JosefR/hvac-sensor-module/readme.md

# Villa Control - HVAC Sensor Module

A simple sonsor module for measuring room temperature and humidity with a CAN
bus interface.

Power: 5-36 V DC

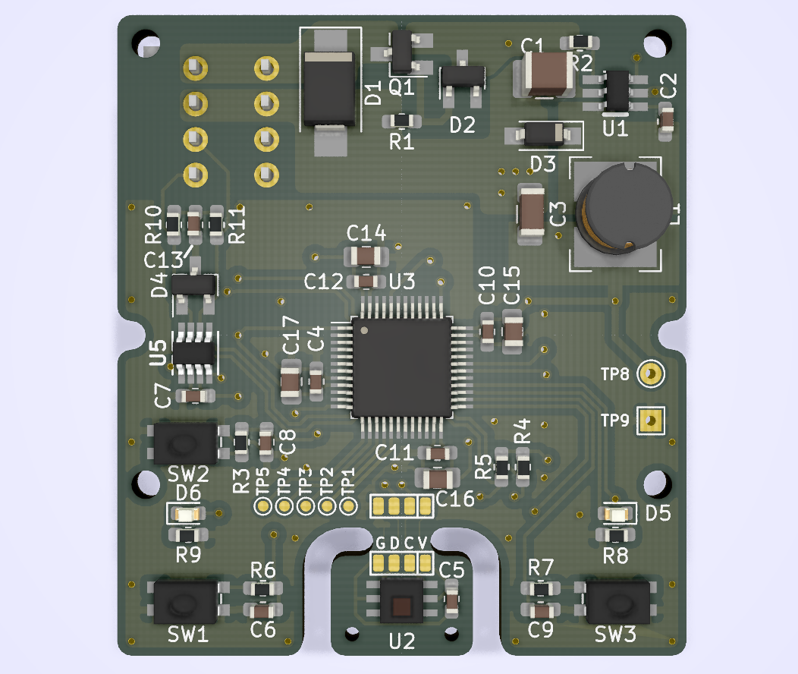
[picture p1: doc/render_front.png]
Image of Sensor Module
