JosefR/hvac-sensor-module/doc/render.png

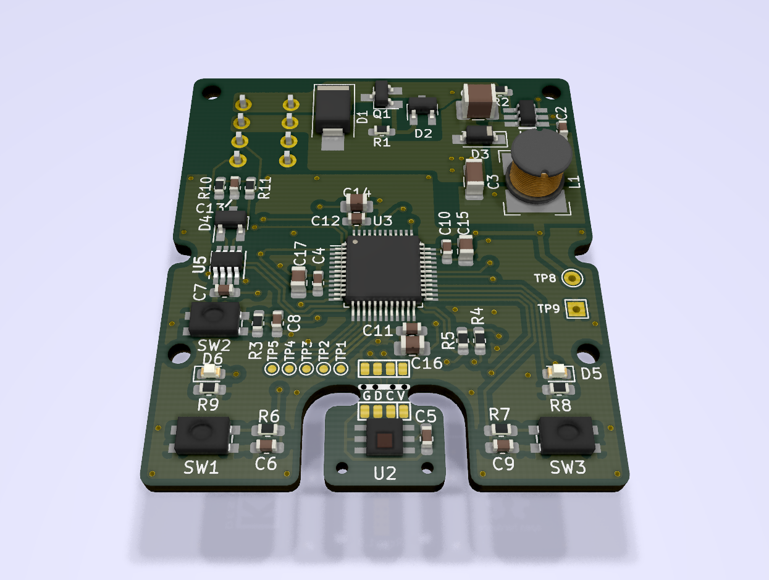
doc/render.png
