JosefR/hvac-sensor-module/doc/render_bottom.png

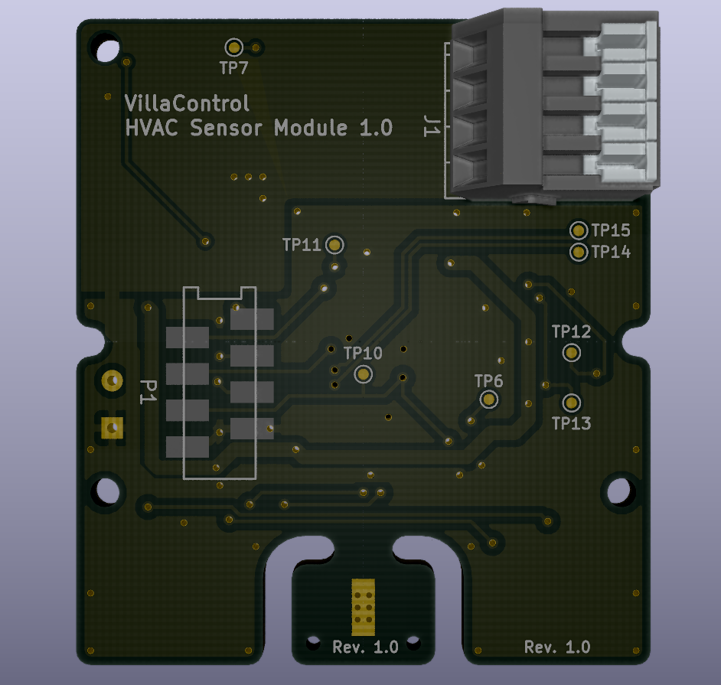
doc/render_bottom.png
