JosefR/hvac-sensor-module/hvac-sensor-module_bom.ods

Position | Value | Footprint | Quantity per PCB | Manufacturer | Distributor | Distributor Link | Distributor Part Number | Price per 1 piece | Price Total | Comment
1 | 100n | C_0603_1608Metric_Pad1.05x0.95mm_HandSolder | 10 | [generic] | Reichelt | https://www.reichelt.de/smd-vielschicht-keramikkondensator-100n-10-x7r-g0603-100n-p31873.html?trstct=pol_0 | X7R-G0603 100N | 0.02 | 0.2
2 | 2.2µF | C_1210_3225Metric_Pad1.42x2.65mm_HandSolder | 1 | [generic] | Reichelt | https://www.reichelt.de/vielschicht-kerko-2-2-f-50v-125-c-kem-x7r1210-2-2u-p207175.html? | KEM X7R1210 2,2U | 0.25 | 0.25 | avalability critical
3 | 22µF | C_1206_3216Metric_Pad1.42x1.75mm_HandSolder | 1 | [generic] | Reichelt | https://www.reichelt.de/smd-vielschichtkondensator-g1206-22-f-10v-x7r-g1206-22-10-p89742.html?trstct=pos_0 | X7R-G1206 22/10 | 0.26 | 0.26
4 | 4n7 | C_0603_1608Metric_Pad1.05x0.95mm_HandSolder | 1 | [generic] | Reichelt | https://www.reichelt.de/vielschicht-kerko-4-7nf-50v-125-c-kem-x7r0603-4-7n-p206991.html?trstct=pol_2 | KEM X7R0603 4,7N | 0.02 | 0.02
5 | 4µ7 | C_0805_2012Metric_Pad1.15x1.40mm_HandSolder | 4 | [generic] | Reichelt | https://www.reichelt.de/smd-kerko-0805-4-7-f-10v-10-mlcc-x5r-0805-cc-4-7u-p194215.html?&trstct=pol_3 | X5R 0805 CC 4,7U | 0.03 | 0.12
6 | 10V | D_SOT-23_ANK_Handsolder | 1 | ON Semiconductor | Mouser | https://www.mouser.de/ProductDetail/ON-Semiconductor/BZX84C10LT1G | 863-BZX84C10LT1G | 0.122 | 0.122
7 | 40.2V | D_SMB_Handsoldering | 1 | Littelfuse | Reichelt | https://www.reichelt.de/zenerdiode-40-v-600-w-do-214aa-p6smb-40ca-smd-p204319.html?&trstct=pos_0 | P6SMB 40CA SMD | 0.17 | 0.17
8 | 50V Vr 1A | D_SOD-123_Handsolder | 1 | ON Semiconductor | Mouser | https://www.mouser.de/ProductDetail/863-NRVTS260ESFT1G | 863-NRVTS260ESFT1G | 0.314 | 0.314
9 | NUP2105L | SOT-23_Handsoldering | 1 | ON Semiconductor | Mouser | https://www.mouser.de/ProductDetail/863-NUP2105LT1G | 863-NUP2105LT1G | 0.341 | 0.341
10 | red | LED_0603_1608Metric_Pad0.88x0.95mm_HandSolder | 2 | Osram | Reichelt | https://www.reichelt.de/led-smd-0603-rot-28-mcd-160-oso-lsq976-p231725.html?&trstct=pol_2 | OSO LSQ976 | 0.06 | 0.12
11 | Conn_01x04 | WAGO_218-104 | 1 | Wago | Voelkner | https://www.voelkner.de/products/55717/WAGO-Federkraftklemmblock-0.50mm-Polzahl-4-Grau-1St..html | D57985 | 1.16 | 1.16
12 | 27µH 220mΩ | SDR0604 | 1 | Bourns | Mouser | https://www.mouser.de/ProductDetail/652-SDR0604-270YL | 652-SDR0604-270YL | 0.41 | 0.41
13 | Debug | micromatch_smd_2x04 | 1 | [generic] | Reichelt | https://www.reichelt.de/buchsenleisten-micro-match-smd-1-27-mm-2x04-mpe-374-1-008-p120025.html? | MPE 374-1-008 | 0.39 | 0.39
14 | FDN5618P | SuperSOT-3_HandSoldering | 1 | Fairchild | Mouser | https://www.mouser.de/ProductDetail/512-FDN5618P | 512-FDN5618P | 0.42 | 0.42
15 | 100k | R_0603_1608Metric_Pad1.05x0.95mm_HandSolder | 2 | [generic] | Reichelt | https://www.reichelt.de/smd-widerstand-0603-100-kohm-100-mw-1-rnd-0603-1-100k-p183102.html? | RND 0603 1 100K | 0.02 | 0.04
16 | 220 | R_0603_1608Metric_Pad1.05x0.95mm_HandSolder | 3 | [generic] | Reichelt | https://www.reichelt.de/smd-widerstand-0603-220-ohm-100-mw-1-rnd-0603-1-220-p183020.html?trstct=pos_0 | RND 0603 1 220 | 0.02 | 0.06
17 | 3.3k | R_0603_1608Metric_Pad1.05x0.95mm_HandSolder | 4 | [generic] | Reichelt | https://www.reichelt.de/smd-widerstand-0603-3-3-kohm-100-mw-1-rnd-0603-1-3-3k-p183065.html?r=1 | RND 0603 1 3,3K | 0.02 | 0.08
18 | 60.4 1% | R_0603_1608Metric_Pad1.05x0.95mm_HandSolder | 2 | [generic] | Reichelt | https://www.reichelt.de/smd-widerstand-0603-60-4-ohm-100-mw-1-rnd-0603-1-60-4-p213146.html?r=1 | RND 0603 1 60,4 | 0.02 | 0.04
19 | SW_PUSH | KMR2_HandSolder | 3 | CK Switches | Reichelt | https://www.reichelt.de/smd-kurzhubtaster-4-2-x-2-8-mm-hoehe-1-9-mm-kmr-231-g-lfs-p148478.html?trstct=pos_0 | KMR 231 G LFS | 0.25 | 0.75
20 | HDC1080 | HDC1080_HandSoldering | 1 | Texas Instruments | Mouser | https://www.mouser.de/ProductDetail/595-HDC1080DMBR | 595-HDC1080DMBR | 2.45 | 2.45
21 | LMR16006 | TI-DDC_HandSoldering | 1 | Texas Instruments | Mouser | https://www.mouser.de/ProductDetail/595-MR16006YQ3DDCRQ1 | 595-MR16006YQ3DDCRQ1 | 2.88 | 2.88
22 | STM32F072C8Tx | LQFP-48_7x7mm_P0.5mm | 1 | ST Microelectronics | Mouser | https://www.mouser.de/ProductDetail/511-STM32F072C8T6 | 511-STM32F072C8T6 | 2.75 | 2.75
23 | TCAN334 | TI-DCN | 1 | Texas Instruments | Mouser | https://www.mouser.de/ProductDetail/595-TCAN334DCNR | 595-TCAN334DCNR | 2.2 | 2.2
