JosefR/hvac-sensor-module/hvac-sensor-module.pdf

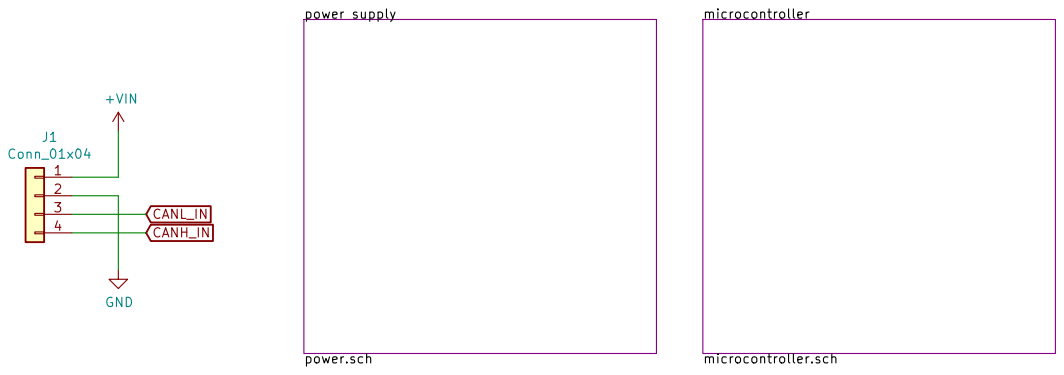
[picture p4: page 1]

File: hvac-sensor-module.sch Sheet: / Josef Raschen

Id: 1/3 Title: VillaControl - HVAC Sensor Module

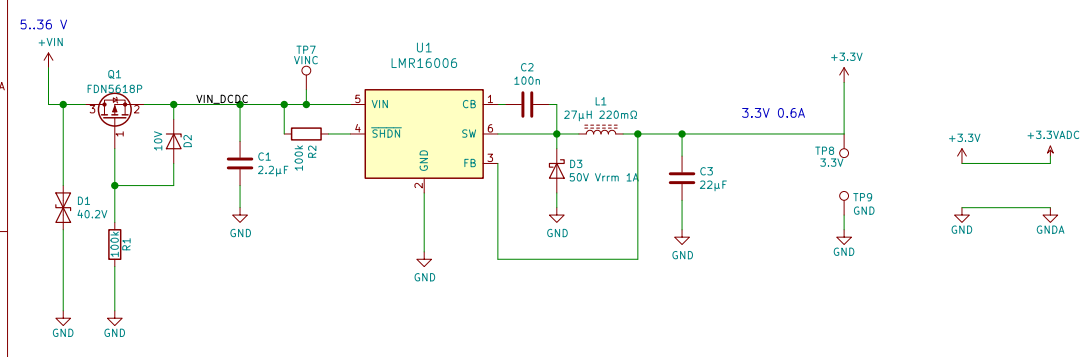
[picture p5: page 2]

2 FB 3 SHDN 4 VIN 5 SW 6 U1
LMR16006

Sheet: /power supply/ Josef Raschen

File: power.sch
Id: 2/3 Title: VillaControl - HVAC Sensor Module

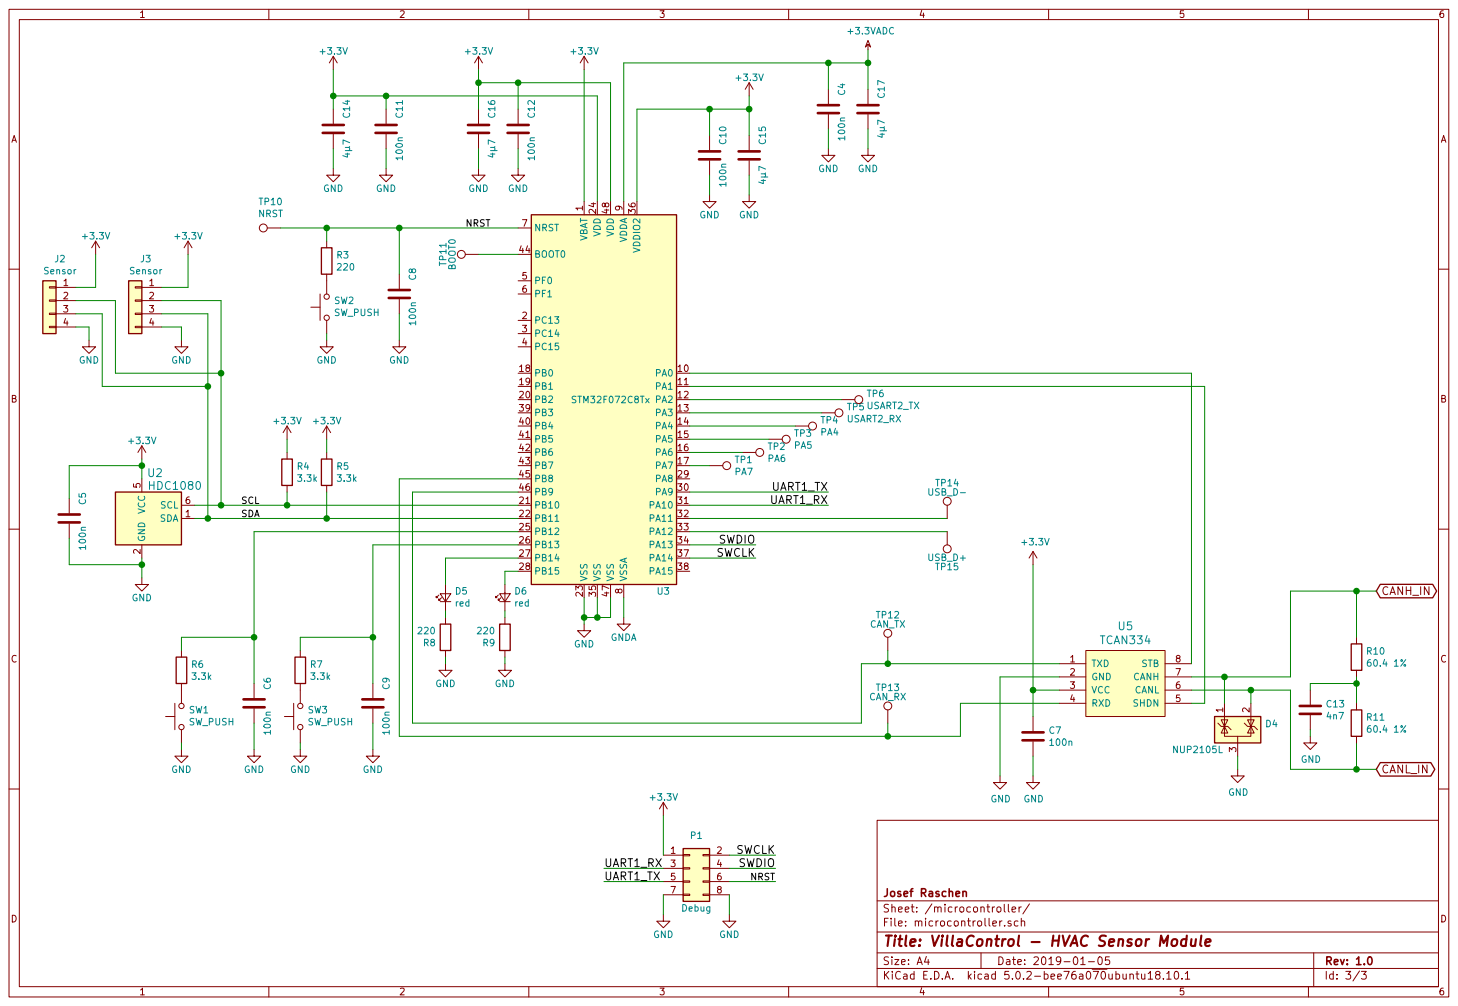
[picture p6: page 3]

9 VDDIO2 36 VSS 23 VSS 35 VSS 47 VSSA

File: microcontroller.sch Sheet: /microcontroller/ Josef Raschen

Id: 3/3 Title: VillaControl - HVAC Sensor Module
