JosefR/hvac-sensor-module/hvac-sensor-module.kicad_pcb

## KiCad design hvac-sensor-module.kicad_pcb (2019-01-09)

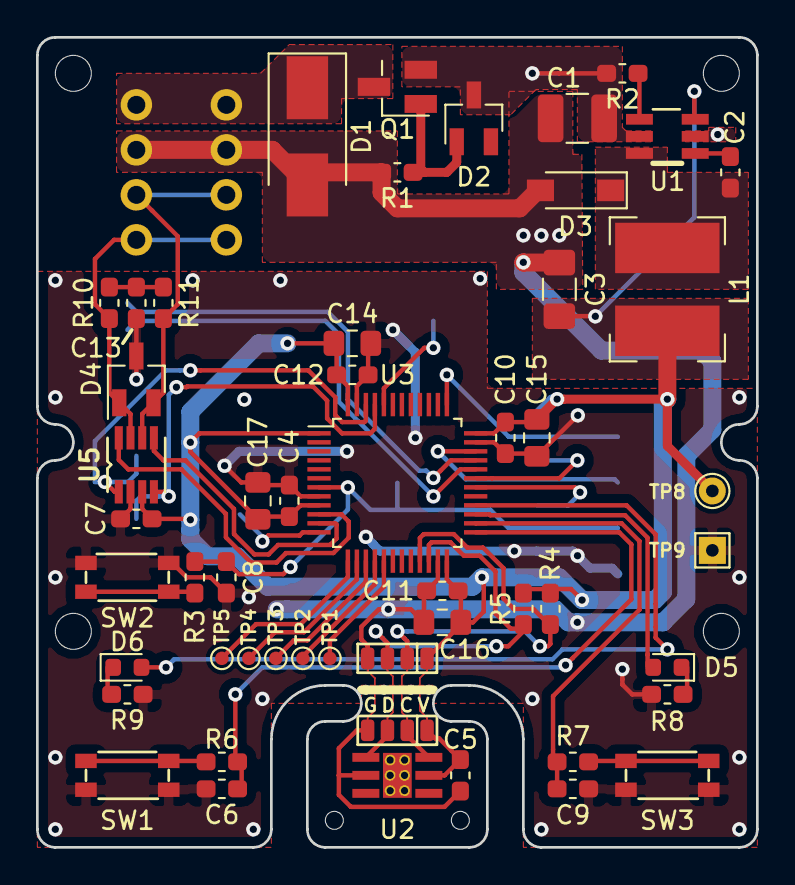
[picture p7: board hvac-sensor-module.kicad_pcb from above]

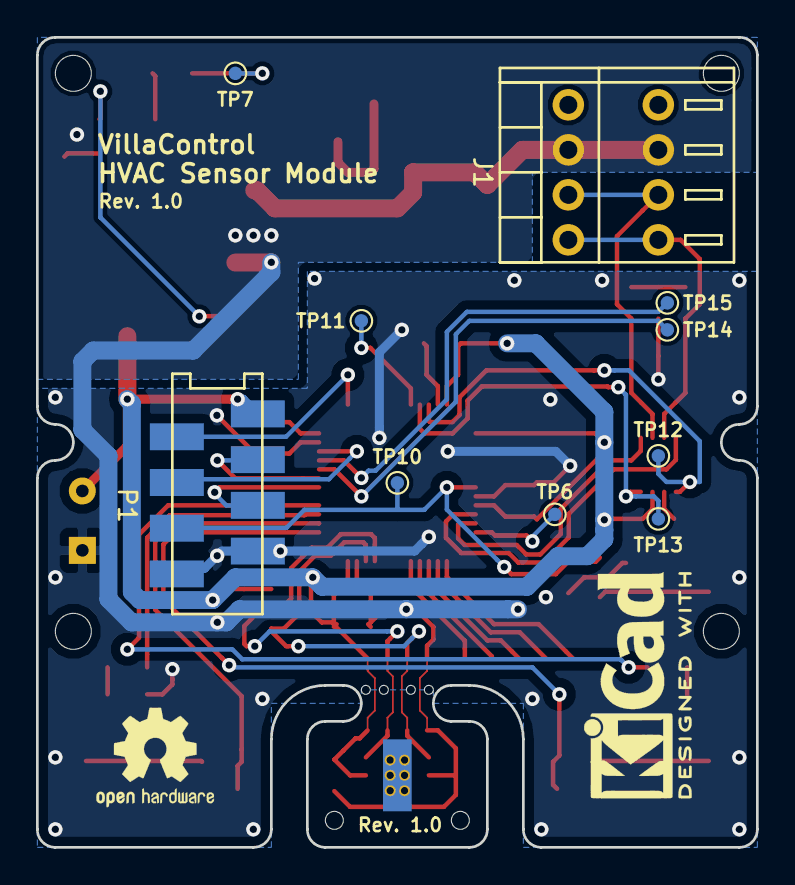
[picture p8: board hvac-sensor-module.kicad_pcb from below]

Board: 2 copper layers, 40.0 x 45.0 mm, 62 parts (10 on the bottom side), 40 nets.

Parts:
C1: 2.2µF; C_1210_3225Metric_Pad1.42x2.65mm_HandSolder
C2, C4, C5, C6, C7, C8, C9, C10, C11, C12: 100n; C_0603_1608Metric_Pad1.05x0.95mm_HandSolder
C3: 22µF; C_1206_3216Metric_Pad1.42x1.75mm_HandSolder
C13: 4n7; C_0603_1608Metric_Pad1.05x0.95mm_HandSolder
C14, C15, C16, C17: 4µ7; C_0805_2012Metric_Pad1.15x1.40mm_HandSolder
D1: 40.2V; D_SMB_Handsoldering
D2: 10V; D_SOT-23_ANK_Handsolder
D3: 50V Vrrm 1A; D_SOD-123_Handsolder
D4: NUP2105L; SOT-23_Handsoldering
D5, D6: red; LED_0603_1608Metric_Pad0.88x0.95mm_HandSolder
J1: Conn_01x04; WAGO_218-104
J2, J3: Sensor; Solder_Connecor_1x04
L1: 27µH 220mΩ; L_Bourns-SDR0604
P1: Debug; micromatch_smd_2x04
Q1: FDN5618P; SuperSOT-3_HandSoldering
R1, R2: 100k; R_0603_1608Metric_Pad1.05x0.95mm_HandSolder
R3, R8, R9: 220; R_0603_1608Metric_Pad1.05x0.95mm_HandSolder
R4, R5, R6, R7: 3.3k; R_0603_1608Metric_Pad1.05x0.95mm_HandSolder
R10, R11: 60.4 1%; R_0603_1608Metric_Pad1.05x0.95mm_HandSolder
SW1, SW2, SW3: SW_PUSH; KMR2_HandSolder
TP1: PA7; TestPoint_Pad_D0.75mm
TP2: PA6; TestPoint_Pad_D0.75mm
TP3: PA5; TestPoint_Pad_D0.75mm
TP4: PA4; TestPoint_Pad_D0.75mm
TP5: USART2_RX; TestPoint_Pad_D0.75mm
TP6: USART2_TX; TestPoint_Pad_D0.75mm
TP7: VINC; TestPoint_Pad_D0.75mm
TP8: 3.3V; TestPoint_THTPad_D1.5mm_Drill0.7mm
TP9: GND; TestPoint_THTPad_1.5x1.5mm_Drill0.7mm
TP10: NRST; TestPoint_Pad_D0.75mm
TP11: BOOT0; TestPoint_Pad_D0.75mm
TP12: CAN_TX; TestPoint_Pad_D0.75mm
TP13: CAN_RX; TestPoint_Pad_D0.75mm
TP14: USB_D-; TestPoint_Pad_D0.75mm
TP15: USB_D+; TestPoint_Pad_D0.75mm
U1: LMR16006; TI-DDC_HandSoldering
U2: HDC1080; HDC1080_HandSoldering
U3: STM32F072C8Tx; LQFP-48_7x7mm_P0.5mm
U5: TCAN334; TI-DCN

Connections:
+3.3VADC: C3.1, C4.1, C5.1, C7.1, C10.1, C11.1, C12.1, C14.1, C15.1, C16.1, C17.1, J2.1, J3.1, L1.2, P1.1, R4.1, R5.1, TP8.1, U1.3, U2.5, U3.1, U3.9, U3.24, U3.36, U3.48, U5.3
+VIN: D1.1, J1.1, Q1.3
/microcontroller/NRST: C8.1, P1.6, R3.1, TP10.1, U3.7
/microcontroller/SCL: J2.2, J3.2, R4.2, U2.6, U3.21
/microcontroller/SDA: J2.3, J3.3, R5.2, U2.1, U3.22
/microcontroller/SWCLK: P1.2, U3.37
/microcontroller/SWDIO: P1.4, U3.34
/microcontroller/UART1_RX: P1.3, U3.31
/microcontroller/UART1_TX: P1.5, U3.30
/power supply/VIN_DCDC: C1.1, D2.1, Q1.2, R2.2, TP7.1, U1.5
CANH_IN: D4.1, J1.4, R10.1, U5.7
CANL_IN: D4.2, J1.3, R11.2, U5.6
GND: C1.2, C3.2, C4.2, C5.2, C6.2, C7.2, C8.2, C9.2, C10.2, C11.2, C12.2, C13.2, C14.2, C15.2, C16.2, C17.2, D1.2, D3.2, D4.3, J1.2, J2.4, J3.4, P1.7, P1.8, R1.2, R8.1, R9.1, SW1.1, SW2.1, SW3.1, TP9.1, U1.2, U2.2, U3.8, U3.23, U3.35, U3.47, U5.2
unnamed: C2.1, D3.1, L1.1, U1.6
unnamed: C2.2, U1.1
unnamed: C6.1, R6.1, U3.25
unnamed: C9.1, R7.1, U3.26
unnamed: C13.1, R10.2, R11.1
unnamed: D2.2, Q1.1, R1.1
unnamed: D5.1, R8.2
unnamed: D5.2, U3.27
unnamed: D6.1, R9.2
unnamed: D6.2, U3.28
unnamed: R2.1, U1.4
unnamed: R3.2, SW2.2
unnamed: R6.2, SW1.2
unnamed: R7.2, SW3.2
unnamed: TP1.1, U3.17
unnamed: TP2.1, U3.16
unnamed: TP3.1, U3.15
unnamed: TP4.1, U3.14
unnamed: TP5.1, U3.13
unnamed: TP6.1, U3.12
unnamed: TP11.1, U3.44
unnamed: TP12.1, U3.46, U5.1
unnamed: TP13.1, U3.45, U5.4
unnamed: TP14.1, U3.32
unnamed: TP15.1, U3.33
unnamed: U3.10, U5.8
unnamed: U3.11, U5.5
