JosefR/hvac-sensor-module/(commit log)

2018-12-27 HVAC Sensor Module Project
    [hvac-sensor-module.kicad_pcb, hvac-sensor-module.sch, microcontroller.sch, power.sch]
2018-12-28 Save before merge.
    [microcontroller.sch, power.sch]
2018-12-28 Pepare footprint assignment (and clean up library issues).
    [hvac-sensor-module.kicad_pcb, hvac-sensor-module.sch, microcontroller.sch, power.sch]
2019-01-02 Layout finished.
    [hvac-sensor-module.kicad_pcb, hvac-sensor-module.sch, microcontroller.sch, power.sch]
2019-01-02 Create PCB panel.
    [hvac-sensor-module_pcb-panel-B.Cu.gbr, hvac-sensor-module_pcb-panel-B.Mask.gbr, hvac-sensor-module_pcb-panel-B.Paste.gbr, hvac-sensor-module_pcb-panel-B.SilkS.gbr, hvac-sensor-module_pcb-panel-Edge.Cuts.gbr, hvac-sensor-module_pcb-panel-F.Cu.gbr, hvac-sensor-module_pcb-panel-F.Mask.gbr, hvac-sensor-module_pcb-panel-F.Paste.gbr]
2019-01-03 Update D1.
    [hvac-sensor-module.kicad_pcb, power.sch]
2019-01-03 Change test point.
    [hvac-sensor-module.kicad_pcb, microcontroller.sch, power.sch]
2019-01-03 Clean up references.
    [hvac-sensor-module.kicad_pcb, microcontroller.sch, power.sch]
2019-01-04 Update some footprints and fine tuning.
    [hvac-sensor-module.kicad_pcb, hvac-sensor-module.sch, microcontroller.sch, power.sch]
2019-01-05 some cleanup
    [hvac-sensor-module.kicad_pcb, hvac-sensor-module.sch, microcontroller.sch, power.sch]
2019-01-05 Add BOM and renderings.
    [hvac-sensor-module_bom.ods]
2019-01-08 Plot single PCB
    [hvac-sensor-module-B.Cu.gbr, hvac-sensor-module-B.Mask.gbr, hvac-sensor-module-B.Paste.gbr, hvac-sensor-module-B.SilkS.gbr, hvac-sensor-module-Edge.Cuts.gbr, hvac-sensor-module-F.Cu.gbr, hvac-sensor-module-F.Mask.gbr, hvac-sensor-module-F.Paste.gbr]
2019-01-09 Add some logos to PCB and update panel.
    [hvac-sensor-module-B.Cu.gbr, hvac-sensor-module-B.Mask.gbr, hvac-sensor-module-B.Paste.gbr, hvac-sensor-module-B.SilkS.gbr, hvac-sensor-module-Edge.Cuts.gbr, hvac-sensor-module-F.Cu.gbr, hvac-sensor-module-F.Mask.gbr, hvac-sensor-module-F.Paste.gbr]
2019-06-24 Update Rendering, Schmatic plot.
    [hvac-sensor-module_bom.ods]
2019-06-24 Add image of board to readme
